GroundStudio/Jade_M1/README.md

GroundStudio Jade M1
====================================
JadeM1

Get it from [ardushop.ro](https://ardushop.ro/ro/118-groundstudio)

Explore all the GroundStudio products at [GroundStudio.ro](https://groundstudio.ro/)

Description
-------------------
ATMEGA2560 based development board with 256kBytes of In-System Self-Programmable Flash program memory, 4kBytes EEPROM, 8kBytes Internal SRAM, 15 PWM Channels, 70 Digital Pins including 16 ADC Pins with 10 bit Resolution and HT42B534 for USB communication.

Contents
-------------------

* [/Documentation](https://github.com/GroundStudio/Jade_M1/tree/main/Documentation) -- Pinout.
* [/Hardware](https://github.com/GroundStudio/Jade_M1/tree/main/Hardware) -- Schematics, layout.

Versions
-------------------
*(Not all tags shown)*

- [REV 1.0.0]

License
-------------------

This is released under the [Attribution-ShareAlike 4.0 International (CC BY-SA 4.0)](https://creativecommons.org/licenses/by-sa/4.0/) license.
**You are welcome to use this for commercial purposes.**

Please consider contributing back to this project or others to help the open-source hardware community continue to thrive and grow!

Certifications:

[Open Source Hardware Association](https://certification.oshwa.org/ro000002.html)   
   
certification-mark-RO000002-wide (https://certification.oshwa.org/ro000002.html)
