GroundStudio/Jade_M1/Documentation/REV1.0.0/REV1.0.0 WAMCMQ_GS JADE_M1 Pinout.pdf

# GroundStudio Jade M1

ATMEGA2560 based development board with 256kBytes of In-System Self-Programmable Flash program memory, 4kBytes EEPROM, 8kBytes Internal SRAM, 15 PWM Channels, 70 Digital Pins including 16 ADC Pins with 10 bit Resolution

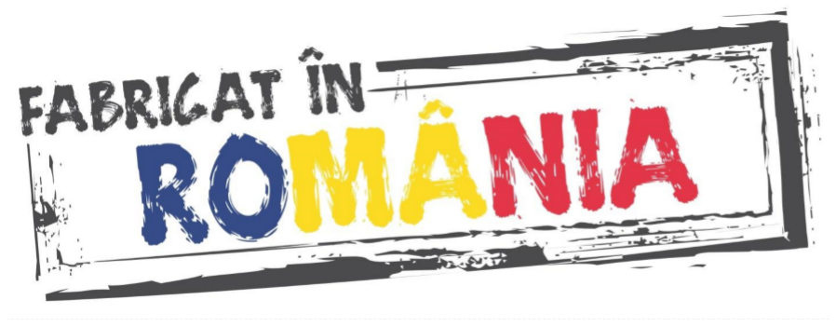
[picture p1: figure]
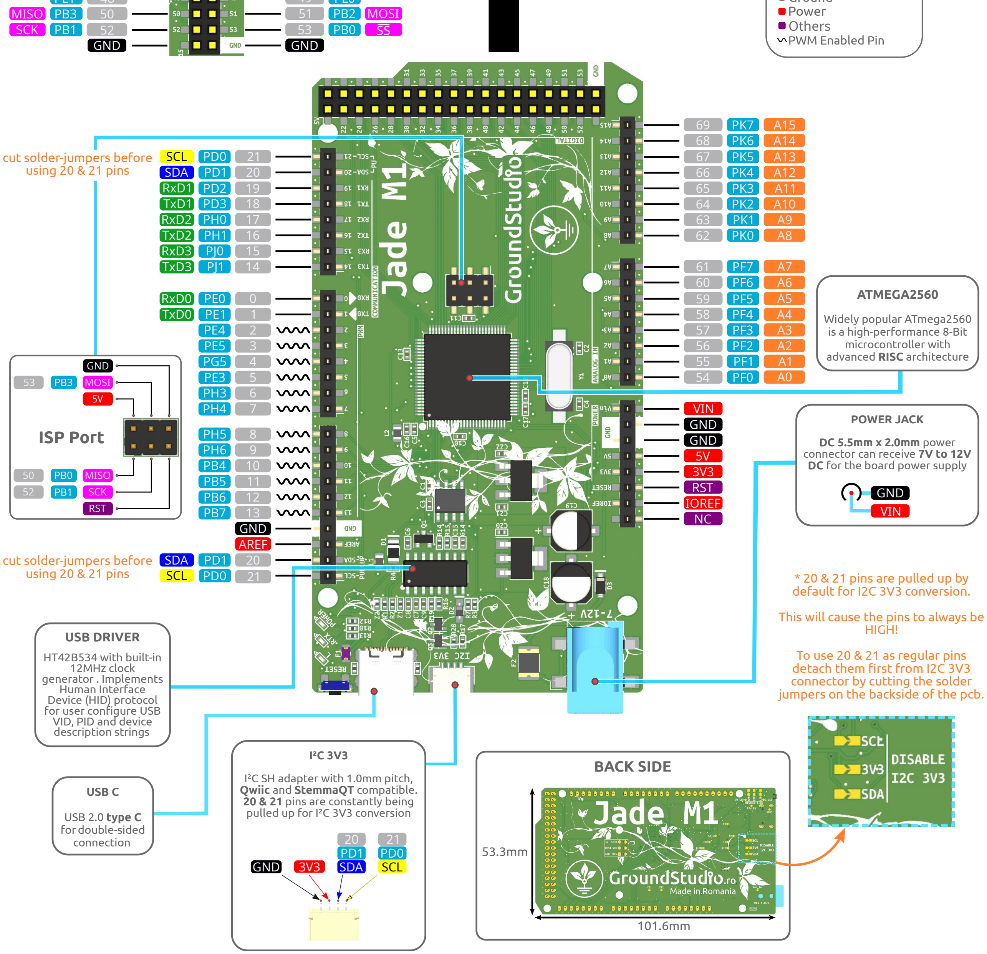
[picture p2: figure]
ISP Port; GND MOSI 5V; PB1 SCK; MISO; RST; TxD0 PE1; RxD0 PE0; TxD1; RxD1; SCL; SDA; AREF; GND; VIN; IOREF; POWER JACK; DC 5.5mm x 2.0mm power connector can receive 7V to 12V DC for the board power supply; TxD2; RxD2; TxD3; RxD3; SCL SDA; PWM Enabled Pin; Power; USB DRIVER; HT42B534 with built-in 12MHz clock generator . Implements Human Interface; Device (HID) protocol; description strings; BACK SIDE; USB C; USB 2.0 type C for double-sided connection; I²C 3V3; I²C SH adapter with 1.0mm pitch, Qwiic and StemmaQT compatible. 20 & 21 pins are constantly being pulled up for I²C 3V3 conversion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
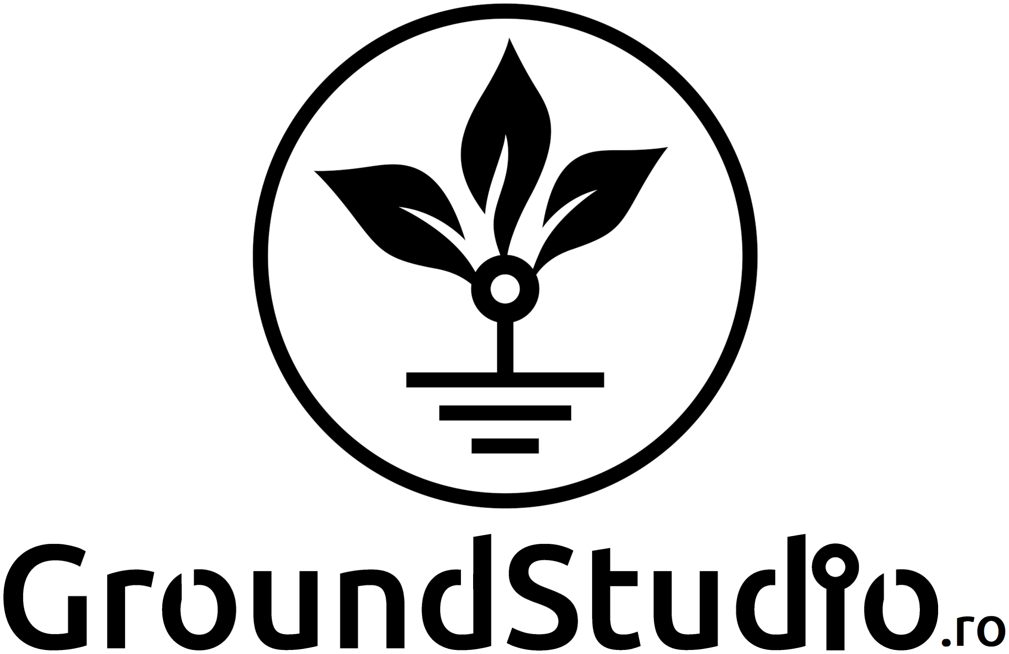
[picture p3: figure]

Board:

Credits: "Arduino Mega 2560 Rev3" by Arduino (https://www.arduino.cc/en/uploads/Main/arduino-mega2560_R3-sch.pdf) "GroundStudio Jade M1" WAMCMQ_GS REV1.0.0

Copyright:

License:

ARDUSHOP SRL 2024

Attribution-ShareAlike 4.0 International

CC BY-SA 4.0 | Pinout REV: 1

PA2
PA4
PA6 | 28
PC7 | 30
PC5 | 32
PC3 | 34
| 26

24

PA0 22

PB1

## MISO

52 | 53 | PB0

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
23 PA1

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
PL5 | 44
PL3 | 46
PL1 | 48
PB3 | 50
| 42

40

PD7 | 38
PC1 | 36
5V | 5V

## SCK

## MOSI

SS

## Digital Pin Number

## SPI USART Pins

## Others

uController Pin

## COLOR DIAGRAM

ADC Channel

SDA

SCL

Ground

for user configure USB VID, PID and device
