GroundStudio/Jade_M1/Documentation/REV1.0.0/REV1.0.0 WAMCMQ_GS JADE_M1 Schematic.pdf

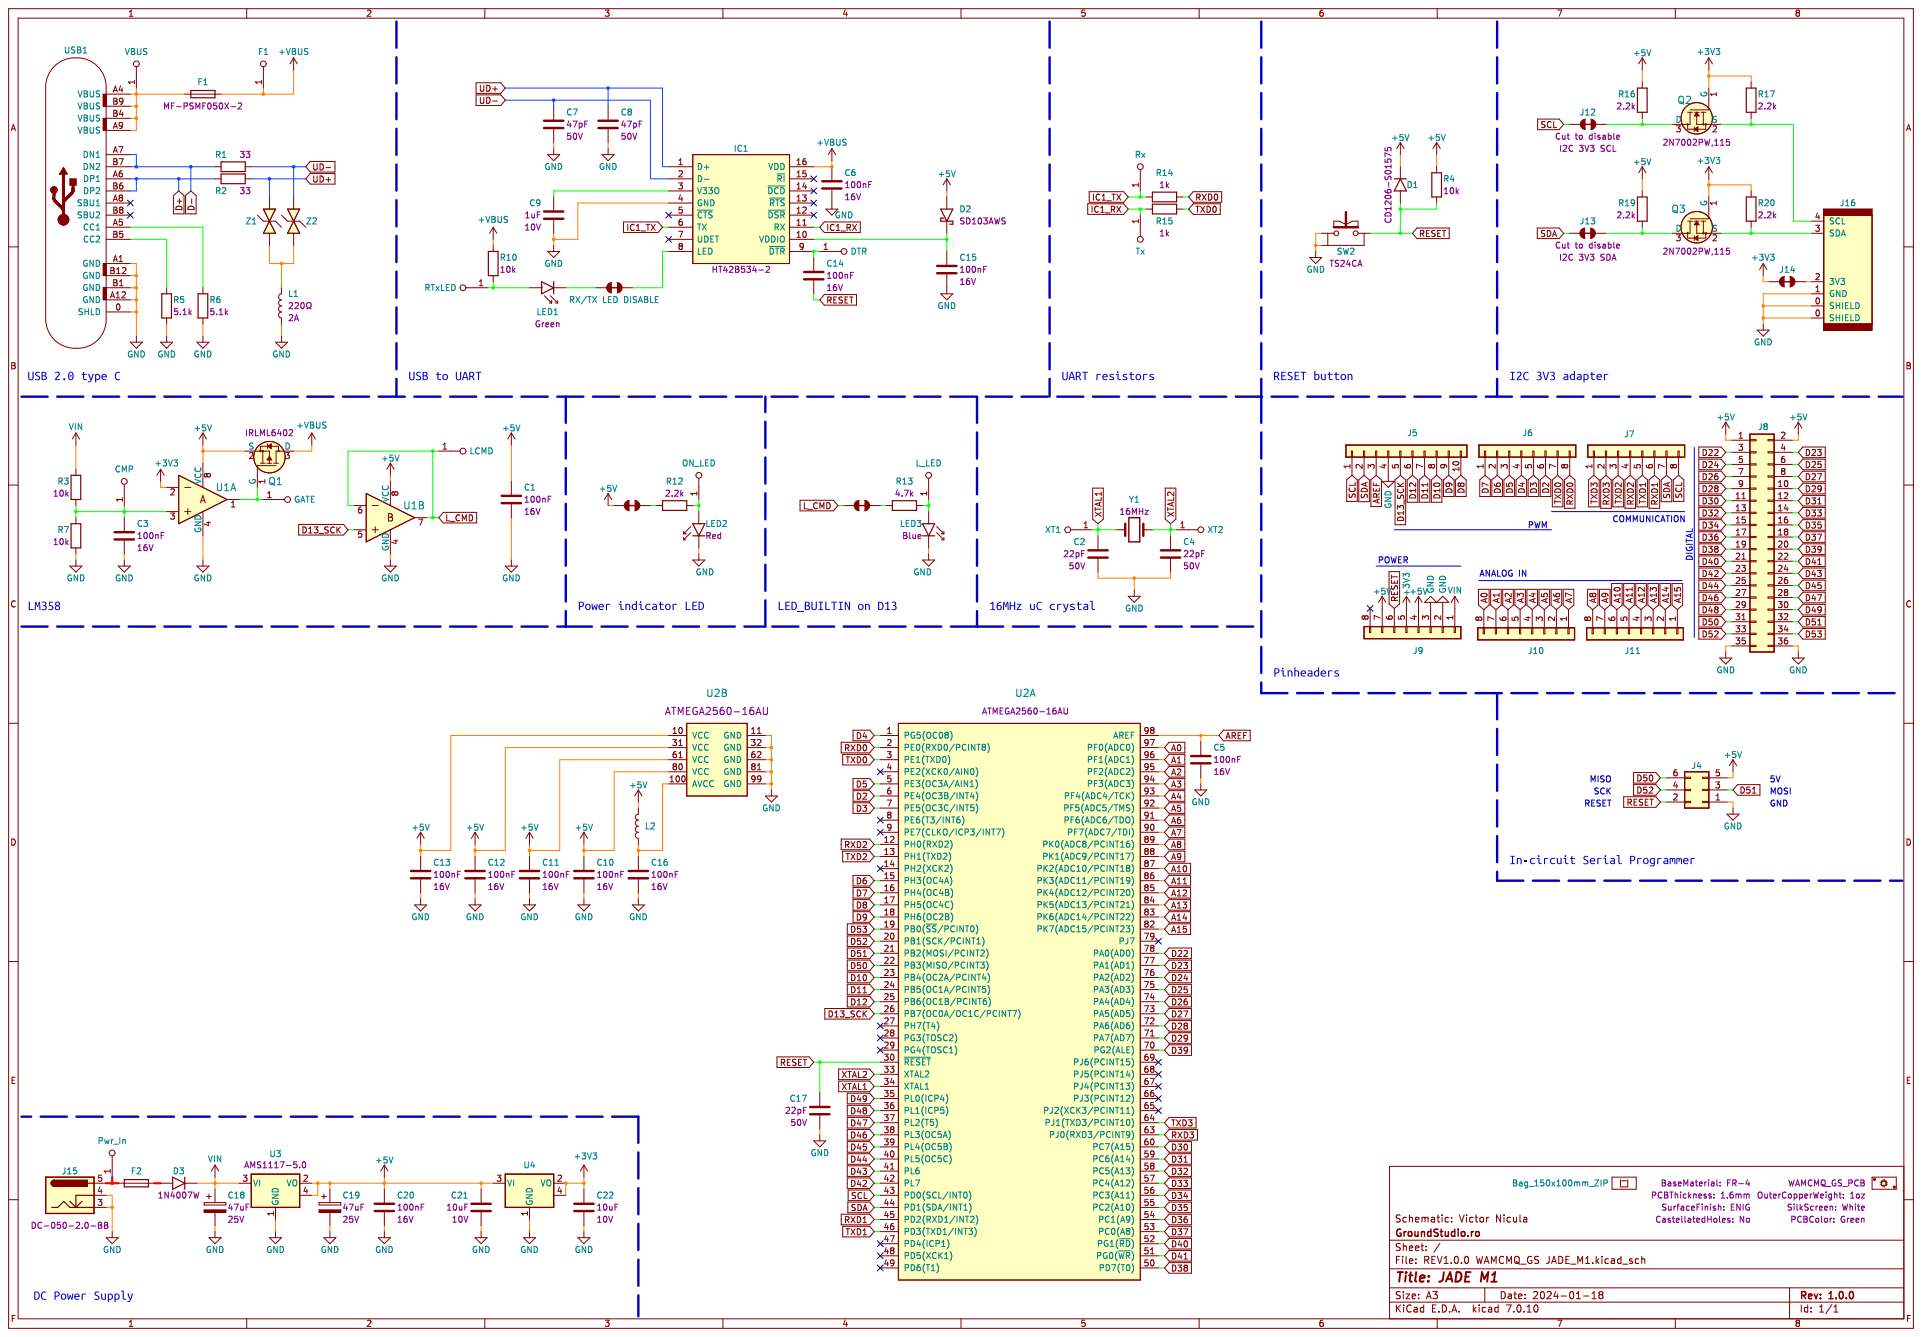
[picture p4: page 1]
