GroundStudio/Jade_M1/Hardware/REV1.0.0 - Kicad7/REV1.0.0 WAMCMQ_GS JADE_M1.kicad_sch

## KiCad design Hardware/REV1.0.0 - Kicad7/REV1.0.0 WAMCMQ_GS JADE_M1.kicad_sch (2024-02-06)

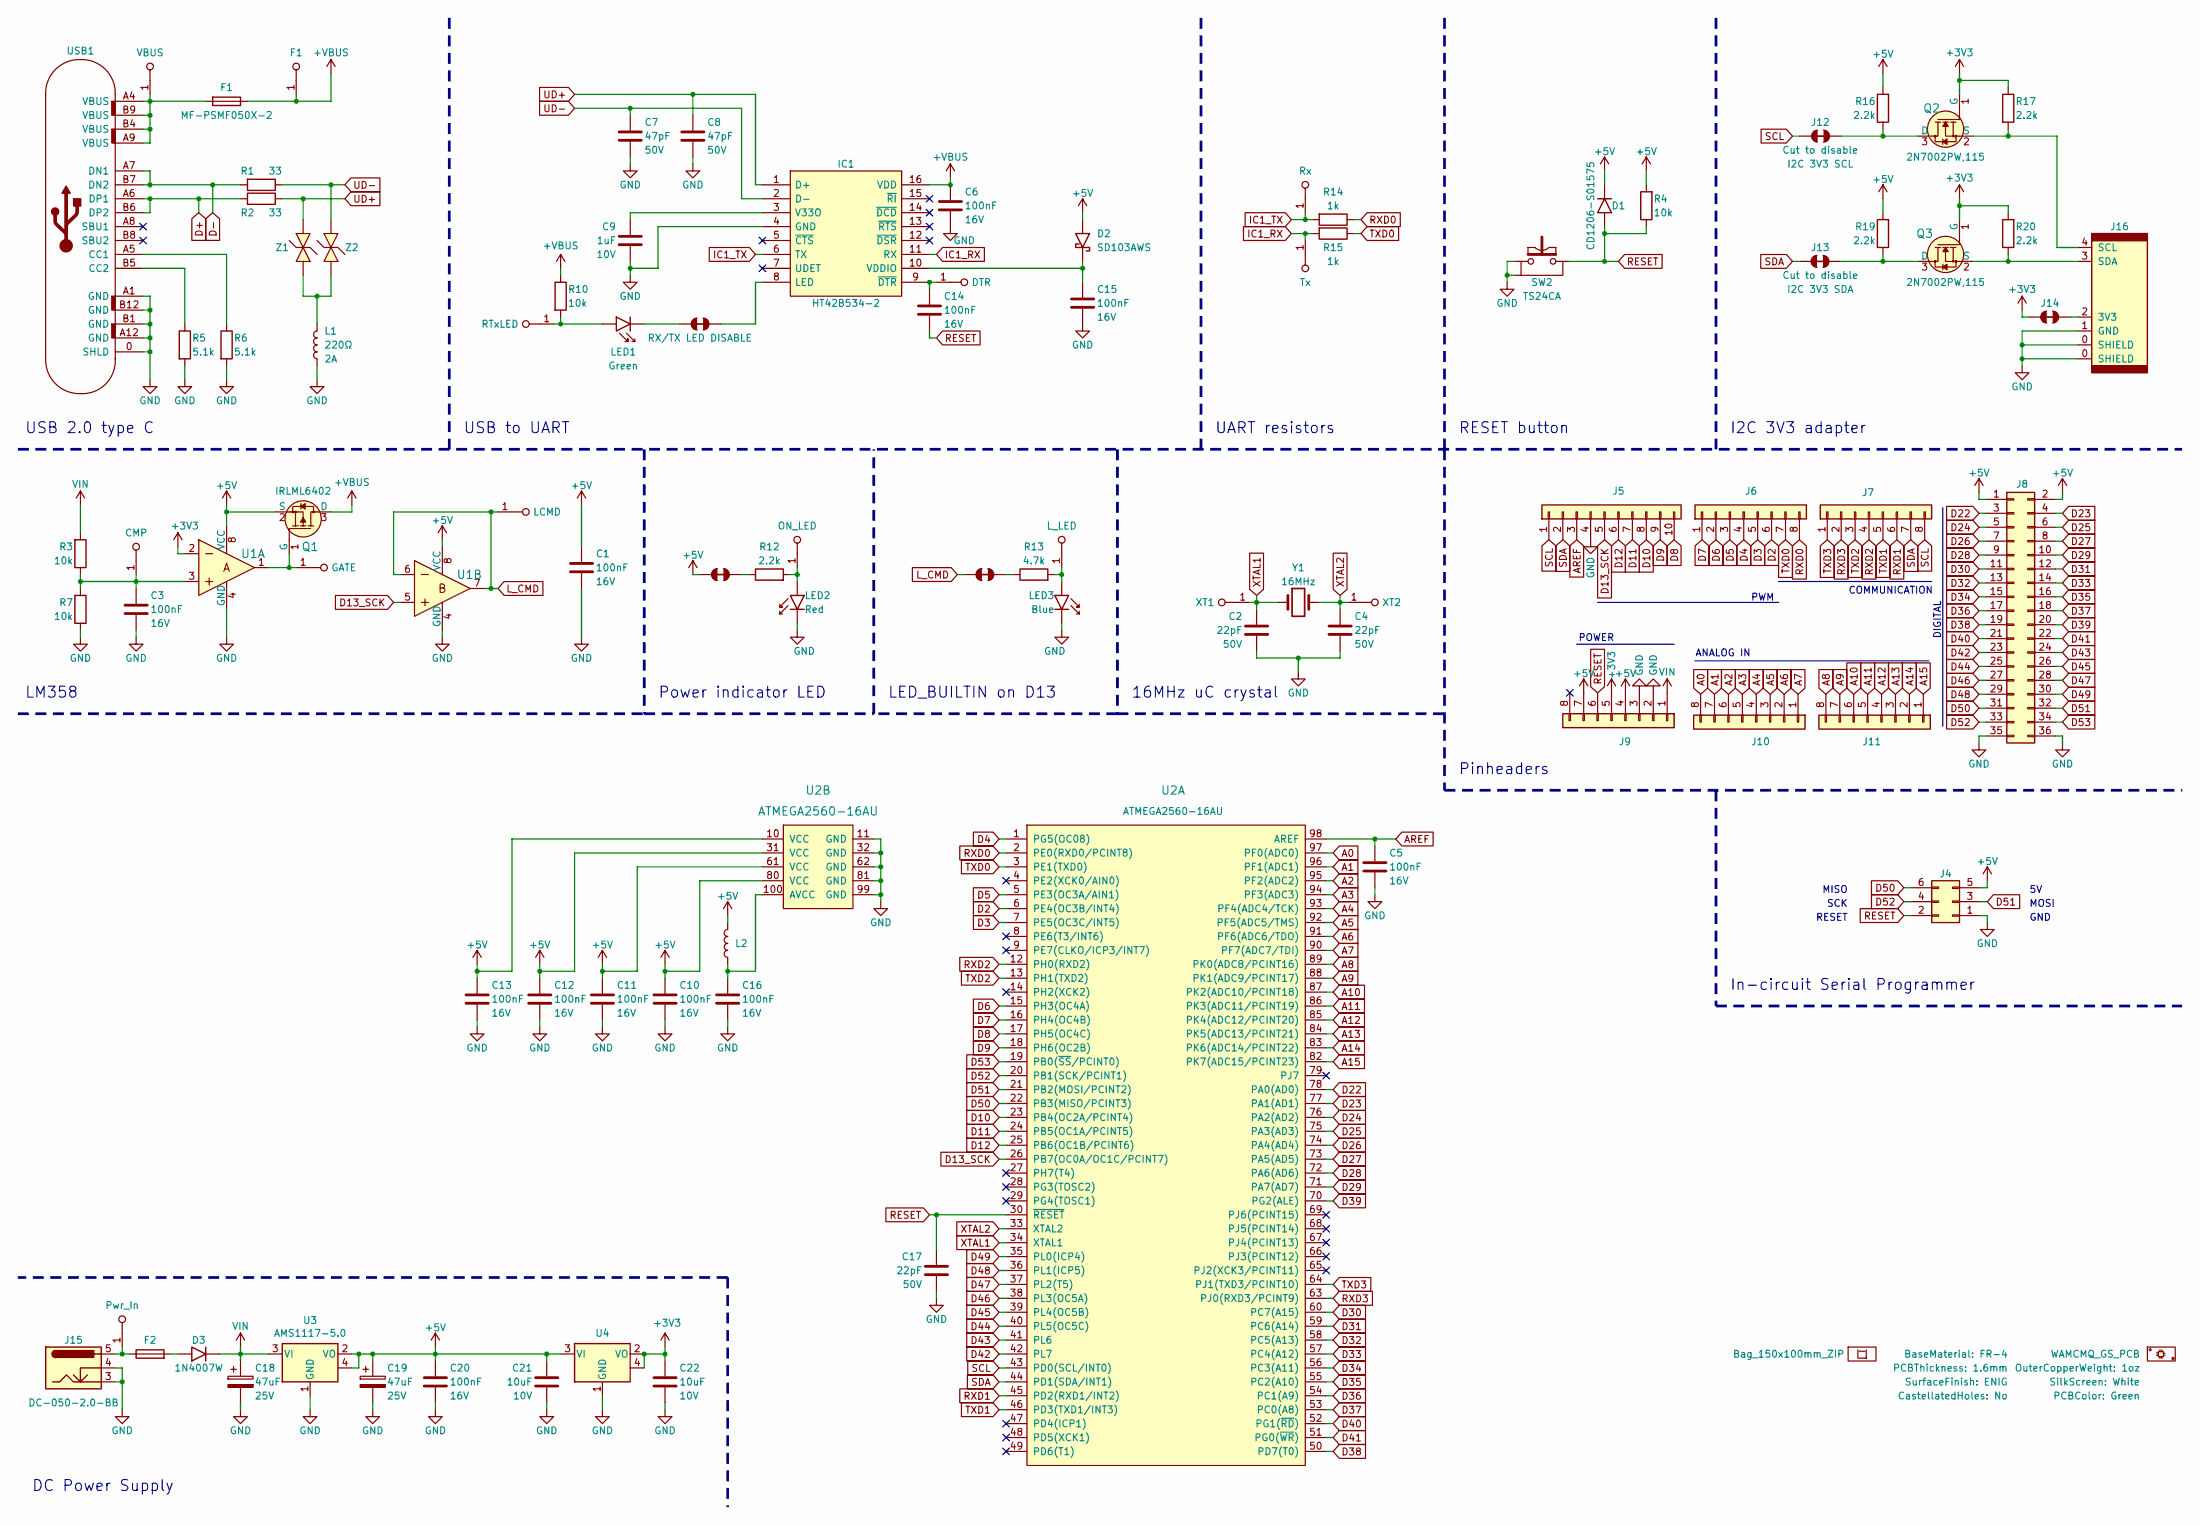
[picture p5: schematic REV1.0.0 WAMCMQ_GS JADE_M1.kicad_sch]

Parts:
B1: Bag_150x100mm_ZIP; MPN AWZMNW_B
C1, C3, C5, C6, C10, C11, C12, C13, C14, C15, C16, C20: C_0402_100nF_16V; C_0402; MPN 0402B104K160CT; LCSC C83056
C2, C4, C17: C_0402_22pF_50V; C_0402; MPN TCC0402C0G220J500AT; LCSC C466226
C7, C8: C_0402_47pF_50V; C_0402; MPN FN15N470J500PNG; LCSC C525215
C9: C_0402_1uF_10V; C_0402; MPN FS15B105K100PKG; LCSC C525324
C18, C19: CP_Elec_6.3x5.4_47uF_25V; CP_Elec_6.3x5.4; MPN CS1E470M-CRE54; LCSC C97807
C21, C22: C_0402_10uF_10V; C_0402; MPN LDK105CBJ106MVLF; LCSC C386033
D1: D_1206_CD1206-S01575; D_1206; MPN CD1206-S01575; LCSC C75465
D2: SOD-323_SD103AWS; SOD-323; MPN SD103AWS; LCSC C438010
D3: SOD-123_1N4007W; SOD-123; MPN 1N4007W; LCSC C108803
F1: Fuse_0805_MF-PSMF050X-2; Fuse_0805; MPN MF-PSMF050X-2; LCSC C116170
F2: Fuse_1812_MF-MSMF050-2; Fuse_1812; MPN MF-MSMF050-2; LCSC C17313
IC1: SOP-16_150MIL_HT42B534-2; SOP-16_150MIL; MPN HT42B534-2; LCSC C493361
J1: RX/TX LED DISABLE; SolderJumper_NC
J2: PWR LED DISABLE; SolderJumper_NC
J3: L LED DISABLE; SolderJumper_NC
J4: PinHeader_2x03_P2.54_V_M; PinS_2x03_P2.54_V_F_SMD+THT; MPN C192301; LCSC C192301
J5: PinHeader_1x10_P2.54_V_F; PinH_1x10_P2.54_V_F_SMD+THT; MPN PinHeader_1x10_P2.54_V_F_SMD_R; LCSC NA
J6, J7, J9, J10, J11: PinHeader_1x8_P2.54_V_F; PinH_1x8_P2.54_V_F_SMD+THT; MPN PinHeader_1x8_P2.54_V_F_SMD_R; LCSC NA
J8: PinHeader_2x18_P2.54_V_M; PinH_2x18_P2.54_V_F_SMD+THT; MPN PinHeader_2x18_P2.54_V_F_SMD; LCSC C132131
J12, J13, J14: SolderJumper_NC; SolderJumper_NC_0.5-A_1Oz_OuterLayer_5C-ΔT
J15: DC-005-5.5-Barr_Jck_SMD; DC-005-5.5-2.0MM-SMD; MPN DC-050-2.0-BB; LCSC C521456
J16: SH_1x04_P1.0_H; SH__1x04_P1.00mm_Horizontal; MPN C145956; LCSC C145956
L1: L_0805_220Ω_2A; L_0805; MPN BLM21PG221SN1D; LCSC C85840
L2: L_0805_SCMI201209X100KT; L_0805; MPN SCMI201209X100KT; LCSC C479906
LED1: LED_0402_GREEN; LED_0402; MPN TZ-P2-0402GTIA1-0.45T; LCSC C688877
LED2: LED_0402_RED; LED_0402; MPN TZ-P2-0402RTIA1-0.45T; LCSC C779449
LED3: LED_0402_BLUE; LED_0402; MPN TZ-P2-0402BTIA1-0.45T; LCSC NA
P1: PCB; MPN WAMCMQ_GS_PCB
Q1: SOT-23_IRLML6402; SOT-23; MPN IRLML6402; LCSC C518785
Q2, Q3: SOT-323 2N7002PW; SOT-323_SC-70; MPN 2N7002PW,115; LCSC C255579
R1, R2: R_0402_33; R_0402; MPN RC-02W33R0FT; LCSC C140161
R3, R4, R7, R10: R_0402_10k; R_0402; MPN 0402WGJ0103TCE; LCSC C25531
R5, R6: R_0402_5.1k; R_0402; MPN RC-02W5101FT; LCSC C294638
R12, R16, R17, R19, R20: R_0402_2.2k; R_0402; MPN RC-02W2201FT; LCSC C258093
R13: R_0402_4.7k; R_0402; MPN WR04X4701FTL; LCSC C163826
R14, R15: R_0402_1k; R_0402; MPN RC-02W1001FT; LCSC C226166
SW2: TS24CA; MPN TS24CA; LCSC C393942
TP1: VBUS; TestPoint
TP2: F1; TestPoint
TP3: LCMD; TestPoint
TP5: CMP; TestPoint
TP6: GATE; TestPoint
TP7: XT1; TestPoint
TP9: XT2; TestPoint
TP10: RTxLED; TestPoint
TP11: DTR; TestPoint
TP12: ON_LED; TestPoint
TP13: L_LED; TestPoint
TP14: Rx; TestPoint
TP15: Tx; TestPoint
TP16: Pwr_In; TestPoint
U1: SOP-8_3.9x4.9_P1.27_LM358; SOP-8_3.9x4.9mm_P1.27mm; MPN LM358; LCSC C329455
U2: ATMEGA2560; TQFP-100_14x14mm_P0.5mm; MPN ATMEGA2560-16AU; LCSC C22460
U3: SOT-223_AMS1117-5.0; SOT-223; MPN AMS1117-5.0; LCSC C473812
U4: SOT-223_AMS1117-3.3; SOT-223; MPN AMS1117-3.3; LCSC C347222
USB1: USB_C_FULL; USB_C_C167321; MPN 918-418K2023S40001; LCSC C167321
Y1: HC49-SMD_5M0-1600A2020; Crystal_HC49-SMD; MPN 5M0-1600A2020-01; LCSC C389693
Z1, Z2: ESD_0402_PS0402V014AT; ESD_0402; MPN PS0402V014AT; LCSC C125914

Connections:
+3V3: C22.1, J9.5, J14.1, Q2.1 (G), Q3.1 (G), R17.1, R20.2, U1.2, U4.2 (VO), U4.4
+5V: C1.1, C10.1, C11.1, C12.1, C13.1, C19.1, C20.1, C21.1, D1.1 (K), D2.2 (A), J2.1, J4.5, J8.1, J8.2, J9.4, J9.7, L2.1, Q1.2 (S), R4.2, R16.2, R19.2, U1.8 (VCC), U2.10 (VCC), U2.31 (VCC), U2.61 (VCC), U2.80 (VCC), U3.2 (VO), U3.4, U4.3 (VI)
+VBUS: C6.1, F1.1, IC1.16 (VDD), Q1.3 (D), R10.1, TP2.1
A0: J10.8, U2.97 (PF0(ADC0))
A1: J10.7, U2.96 (PF1(ADC1))
A2: J10.6, U2.95 (PF2(ADC2))
A3: J10.5, U2.94 (PF3(ADC3))
A4: J10.4, U2.93 (PF4(ADC4/TCK))
A5: J10.3, U2.92 (PF5(ADC5/TMS))
A6: J10.2, U2.91 (PF6(ADC6/TDO))
A7: J10.1, U2.90 (PF7(ADC7/TDI))
A8: J11.8, U2.89 (PK0(ADC8/PCINT16))
A9: J11.7, U2.88 (PK1(ADC9/PCINT17))
A10: J11.6, U2.87 (PK2(ADC10/PCINT18))
A11: J11.5, U2.86 (PK3(ADC11/PCINT19))
A12: J11.4, U2.85 (PK4(ADC12/PCINT20))
A13: J11.3, U2.84 (PK5(ADC13/PCINT21))
A14: J11.2, U2.83 (PK6(ADC14/PCINT22))
A15: J11.1, U2.82 (PK7(ADC15/PCINT23))
AREF: C5.1, J5.3, U2.98 (AREF)
D2: J6.6, U2.6 (PE4(OC3B/INT4))
D3: J6.5, U2.7 (PE5(OC3C/INT5))
D4: J6.4, U2.1 (PG5(OC08))
D5: J6.3, U2.5 (PE3(OC3A/AIN1))
D6: J6.2, U2.15 (PH3(OC4A))
D7: J6.1, U2.16 (PH4(OC4B))
D8: J5.10, U2.17 (PH5(OC4C))
D9: J5.9, U2.18 (PH6(OC2B))
D10: J5.8, U2.23 (PB4(OC2A/PCINT4))
D11: J5.7, U2.24 (PB5(OC1A/PCINT5))
D12: J5.6, U2.25 (PB6(OC1B/PCINT6))
D13_SCK: J5.5, U1.5, U2.26 (PB7(OC0A/OC1C/PCINT7))
D22: J8.3, U2.78 (PA0(AD0))
D23: J8.4, U2.77 (PA1(AD1))
D24: J8.5, U2.76 (PA2(AD2))
D25: J8.6, U2.75 (PA3(AD3))
D26: J8.7, U2.74 (PA4(AD4))
D27: J8.8, U2.73 (PA5(AD5))
D28: J8.9, U2.72 (PA6(AD6))
D29: J8.10, U2.71 (PA7(AD7))
D30: J8.11, U2.60 (PC7(A15))
D31: J8.12, U2.59 (PC6(A14))
D32: J8.13, U2.58 (PC5(A13))
D33: J8.14, U2.57 (PC4(A12))
D34: J8.15, U2.56 (PC3(A11))
D35: J8.16, U2.55 (PC2(A10))
D36: J8.17, U2.54 (PC1(A9))
D37: J8.18, U2.53 (PC0(A8))
D38: J8.19, U2.50 (PD7(T0))
D39: J8.20, U2.70 (PG2(ALE))
D40: J8.21, U2.52 (PG1(~RD))
D41: J8.22, U2.51 (PG0(~WR))
D42: J8.23, U2.42 (PL7)
D43: J8.24, U2.41 (PL6)
D44: J8.25, U2.40 (PL5(OC5C))
D45: J8.26, U2.39 (PL4(OC5B))
D46: J8.27, U2.38 (PL3(OC5A))
D47: J8.28, U2.37 (PL2(T5))
D48: J8.29, U2.36 (PL1(ICP5))
D49: J8.30, U2.35 (PL0(ICP4))
D50: J4.6, J8.31, U2.22 (PB3(MISO/PCINT3))
D51: J4.3, J8.32, U2.21 (PB2(MOSI/PCINT2))
D52: J4.4, J8.33, U2.20 (PB1(SCK/PCINT1))
D53: J8.34, U2.19 (PB0(~SS/PCINT0))
D+: R2.2, USB1.A6 (DP1), USB1.B6 (DP2)
D-: R1.2, USB1.A7 (DN1), USB1.B7 (DN2)
GND: C1.2, C2.1, C3.2, C4.2, C5.2, C6.2, C7.1, C8.2, C9.2, C10.2, C11.2, C12.2, C13.2, C15.2, C16.1, C17.2, C18.2, C19.2, C20.2, C21.2, C22.2, IC1.4 (GND), J4.1, J5.4, J8.35, J8.36, J9.2, J9.3, J15.3, J15.4, J16.0 (SHIELD), J16.1 (GND), L1.1, LED2.1 (K), LED3.1 (K), R5.2, R6.2, R7.1, SW2.1, SW2.3, U1.4 (GND), U2.11 (GND), U2.32 (GND), U2.62 (GND), U2.81 (GND), U2.99 (GND), U3.1 (GND), U4.1 (GND), USB1.0 (SHLD), USB1.A1 (GND), USB1.A12 (GND), USB1.B1 (GND), USB1.B12 (GND)
IC1_RX: IC1.11 (RX), R15.2, TP15.1
IC1_TX: IC1.6 (TX), R14.2, TP14.1
L_CMD: J3.1, TP3.1, U1.6, U1.7
unnamed: C3.1, R3.1, R7.2, TP5.1, U1.3
unnamed: C9.1, IC1.3 (V33O)
unnamed: C14.1, IC1.9 (~DTR), TP11.1
unnamed: C15.1, D2.1 (K), IC1.10 (VDDIO)
unnamed: C16.2, L2.2, U2.100 (AVCC)
unnamed: D3.2 (A), F2.2
unnamed: F1.2, TP1.1, USB1.A4 (VBUS), USB1.A9 (VBUS), USB1.B4 (VBUS), USB1.B9 (VBUS)
unnamed: F2.1, J15.5, TP16.1
unnamed: IC1.8 (LED), J1.1
unnamed: J1.2, LED1.1 (K)
unnamed: J2.2, R12.1
unnamed: J3.2, R13.1
unnamed: J12.1, Q2.3 (D), R16.1
unnamed: J13.2, Q3.3 (D), R19.1
unnamed: J14.2, J16.2 (3V3)
unnamed: J16.3 (SDA), Q3.2 (S), R20.1
unnamed: J16.4 (SCL), Q2.2 (S), R17.2
unnamed: L1.2, Z1.2, Z2.2
unnamed: LED1.2 (A), R10.2, TP10.1
unnamed: LED2.2 (A), R12.2, TP12.1
unnamed: LED3.2 (A), R13.2, TP13.1
unnamed: Q1.1 (G), TP6.1, U1.1
unnamed: R5.1, USB1.B5 (CC2)
unnamed: R6.1, USB1.A5 (CC1)
RESET: C14.2, C17.1, D1.2 (A), J4.2, J9.6, R4.1, SW2.4, U2.30 (~RESET)
RXD0: J6.8, R14.1, U2.2 (PE0(RXD0/PCINT8))
RXD1: J7.6, U2.45 (PD2(RXD1/INT2))
RXD2: J7.4, U2.12 (PH0(RXD2))
RXD3: J7.2, U2.63 (PJ0(RXD3/PCINT9))
SCL: J5.1, J7.8, J12.2, U2.43 (PD0(SCL/INT0))
SDA: J5.2, J7.7, J13.1, U2.44 (PD1(SDA/INT1))
TXD0: J6.7, R15.1, U2.3 (PE1(TXD0))
TXD1: J7.5, U2.46 (PD3(TXD1/INT3))
TXD2: J7.3, U2.13 (PH1(TXD2))
TXD3: J7.1, U2.64 (PJ1(TXD3/PCINT10))
UD+: C8.1, IC1.1 (D+), R2.1, Z1.1
UD-: C7.2, IC1.2 (D-), R1.1, Z2.1
VIN: C18.1, D3.1 (K), J9.1, R3.2, U3.3 (VI)
XTAL1: C2.2, TP7.1, U2.34 (XTAL1), Y1.1
XTAL2: C4.1, TP9.1, U2.33 (XTAL2), Y1.2

Notes on the sheet:
MOSI
PWM
RESET
MISO
LM358
Power indicator LED
Pinheaders
USB to UART
DIGITAL
I2C 3V3 adapter
DC Power Supply
USB 2.0 type C
GND
16MHz uC crystal
POWER
SCK
LED_BUILTIN on D13
RESET button
COMMUNICATION
ANALOG IN
UART resistors
In-circuit Serial Programmer
